ShellAlbert/TinyBMS/Schematic/BMS.png

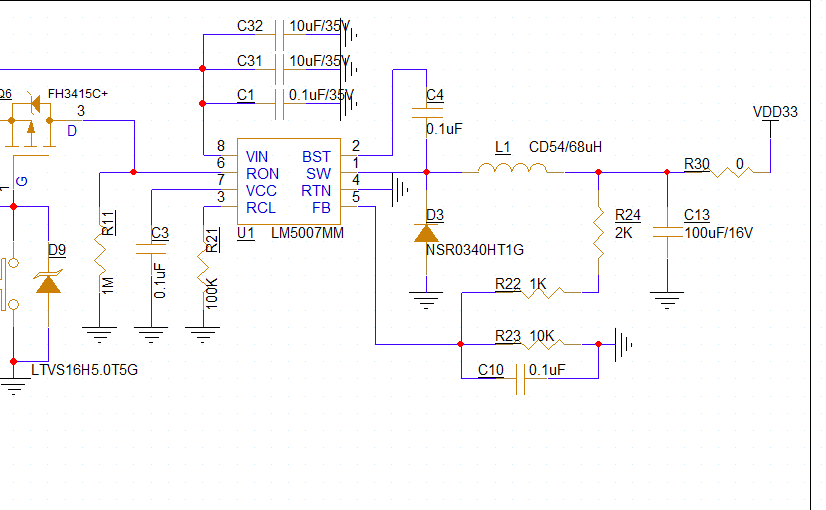
Schematic/BMS.png
