ShellAlbert/TinyBMS/(list of files, drawings)

Other design files:
Schematic/BMS.DSN
Schematic/BMS.opj
Schematic/LIBRARY1.OLB
