ShellAlbert/TinyBMS/Code/Core/Src/main.c

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
/* Includes ------------------------------------------------------------------*/
#include "main.h"

/* USER CODE BEGIN Includes */
#include "stm32f1xx_hal.h"
#include "Zsy_FlashOP.h"
#include "Zsy_Registers.h"
#include "Zsy_Utils.h"
#include "Zsy_BQ76920.h"
#define BMS_I2C_ADDRESS 0x18
/* USER CODE END Includes */

ADC_HandleTypeDef hadc1;

CRC_HandleTypeDef hcrc;

I2C_HandleTypeDef hi2c1;

RTC_HandleTypeDef hrtc;

SPI_HandleTypeDef hspi1;

TIM_HandleTypeDef htim1;

UART_HandleTypeDef huart1;
UART_HandleTypeDef huart2;

void SystemClock_Config(void);
static void MX_GPIO_Init(void);
static void MX_CRC_Init(void);
static void MX_I2C1_Init(void);
static void MX_RTC_Init(void);
static void MX_USART1_UART_Init(void);
static void MX_USART2_UART_Init(void);
static void MX_TIM1_Init(void);
static void MX_ADC1_Init(void);
static void MX_SPI1_Init(void);
/* USER CODE BEGIN 0 */
//68.9Ah = 68.9A*1h=68.9A*3600s=68.9A*3600*1000ms
#define TOTAL_CAPACITY	(68.9*3600*1000)

uint32_t gFlashData[2];
//[0]:SoC, 0%~100.0%.  99.9%=999.
//[1]:Q, in unit of AMP_second.
/* USER CODE END 0 */

/**
  * @brief  The application entry point.
  * @retval int
  */
int main(void)
{
  /* USER CODE BEGIN 1 */
  float fPT100Res[4];
  float fPT100Celsius[4];
  /* USER CODE END 1 */

  /* MCU Configuration--------------------------------------------------------*/

  /* Reset of all peripherals, Initializes the Flash interface and the Systick. */
  HAL_Init();

  /* Configure the system clock */
  SystemClock_Config();

  /* Initialize all configured peripherals */
  MX_GPIO_Init();
  MX_CRC_Init();
  MX_I2C1_Init();
  MX_RTC_Init();
  MX_USART1_UART_Init();
  MX_USART2_UART_Init();
  MX_TIM1_Init();
  MX_ADC1_Init();
  MX_SPI1_Init();
  /* USER CODE BEGIN 2 */
  HAL_GPIO_WritePin(GPIOA, LED0_Pin|LED1_Pin, GPIO_PIN_RESET);
  //Rising edge to turn BMS ON.
  HAL_GPIO_WritePin(GPIOB, BMS_ON_Pin, GPIO_PIN_RESET);
  HAL_Delay(1000);
  HAL_GPIO_WritePin(GPIOB, BMS_ON_Pin, GPIO_PIN_SET);
  HAL_Delay(1000);
  HAL_GPIO_WritePin(GPIOB, BMS_ON_Pin, GPIO_PIN_RESET);



  //H-Bridge
  //CTL1,CTL2.
  HAL_GPIO_WritePin(GPIOB, CTL1_Pin, GPIO_PIN_RESET);
  HAL_GPIO_WritePin(GPIOB, CTL2_Pin, GPIO_PIN_SET);

  BQ76920_init ();
  enableCharging ();
  enableDischarging ();
  enableBalancing ();

  // read stored data from Embedded Flash.
  //read 2*sizeof(int) data.
  if (!ZsyFlashRead ((unsigned int*) gFlashData, 2))
    {
      if (gFlashData[0] == 0 || gFlashData[1] == 0)
	{
	  //first time after Programming.
	  //read registers to calculate Pack Voltage.
	  updateVoltages ();
	  //use Open-Circuit-Voltage to initial SoC.
	  gBQ76920Dev.iSoC = Zsy_MapVol2SoC (gBQ76920Dev.batVoltage);
	  gBQ76920Dev.iAMPSec = gBQ76920Dev.iSoC/1000.0f*TOTAL_CAPACITY;
	}
      else
	{
	  //Read back previous stored value.
	  gBQ76920Dev.iSoC = gFlashData[0];
	  gBQ76920Dev.iAMPSec = gFlashData[1];
	}
    }

  /* USER CODE END 2 */

  /* Infinite loop */
  /* USER CODE BEGIN WHILE */
  while (1)
    {
#if 1
      //read PT100.
      fPT100Res[0]=Zsy_GetPT100Resistance(0);
      fPT100Res[1]=Zsy_GetPT100Resistance(1);
      fPT100Res[2]=Zsy_GetPT100Resistance(2);
      fPT100Res[3]=Zsy_GetPT100Resistance(3);
      //convert PT100 resistance to Temperature in Celsius unit.
      fPT100Celsius[0]=Zsy_PT100_to_Temperature(fPT100Res[0]);
      fPT100Celsius[1]=Zsy_PT100_to_Temperature(fPT100Res[1]);
      fPT100Celsius[2]=Zsy_PT100_to_Temperature(fPT100Res[2]);
      fPT100Celsius[3]=Zsy_PT100_to_Temperature(fPT100Res[3]);
#endif

      HAL_GPIO_WritePin(GPIOA, LED0_Pin|LED1_Pin, GPIO_PIN_RESET);
      getDieTemperature ();
      dumpRegisters ();
      checkStatus ();
      HAL_GPIO_WritePin(GPIOA, LED0_Pin|LED1_Pin, GPIO_PIN_SET);
      updateVoltages ();
      updateCurrent (1);

    /* USER CODE END WHILE */

    /* USER CODE BEGIN 3 */
    }
  /* USER CODE END 3 */
}

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
