ShellAlbert/TinyBMS/(commit log)

2022-10-28 battery management.
    [BMS.DSN, BMS.opj, LIBRARY1.OLB]
2022-11-19 first schematic.
    [BMS.DSN, BMS.opj, LIBRARY1.OLB]
2022-11-20 First version of PCB Layout.
    [BMS.DSN, BMS.opj, LIBRARY1.OLB, TinyBMS-1.brd, TinyBMS-2.brd, TinyBMS-3.brd, TinyBMS-4.brd, TinyBMS-5.brd]
2022-11-21 Before Fabrication. Check footprints tomorrow.
    [BMS.DSN, BMS.opj, TinyBMS-1.brd, TinyBMS-2.brd, TinyBMS-3.brd, TinyBMS-4.brd, TinyBMS-5.brd, TinyBMS-8.brd]
2022-11-22 FIRST LAYOUT.
    [TinyBMS-8.brd, TinyBMS-9.brd, TinyBMS-A1.brd]
2022-11-26 Program workflow.
    [BMS.DSN, BMS.opj, BOM.xls, TinyBMS-A1.brd, art_param.txt, nc_param.txt]
2022-12-09 Add codes for BQ76920.
    [BMS.opj]
2022-12-16 PT100 Debug Successfully.
    [BMS.opj, art_param.txt, cases.cfg, nc_param.txt]
